freetronics/RelayDriverShield8/RelayDriverShield8-v2_1-schematic.pdf

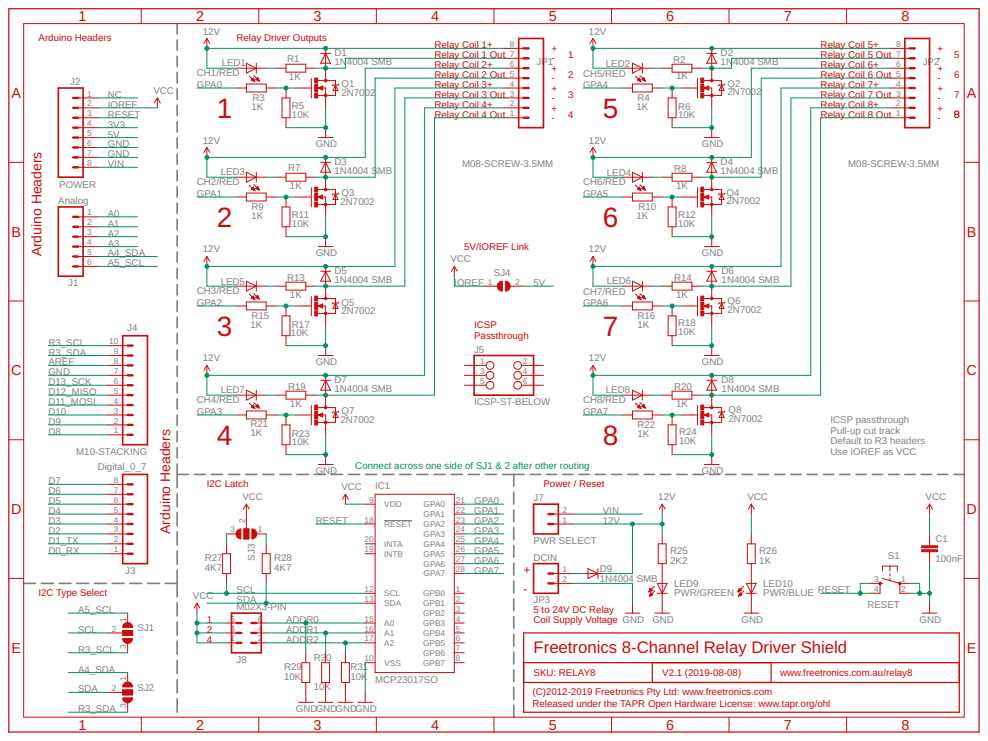
[picture p1: page 1]

Relay Coil 1+ Relay Coil 2+ Relay Coil 3+ Relay Coil 4+ Relay Coil 4 Out
Relay Coil 1 Out
Relay Coil 2 Out
Relay Coil 3 Out

Relay Coil 5+ Relay Coil 5 Out
Relay Coil 6+ Relay Coil 6 Out
Relay Coil 7+ Relay Coil 7 Out
Relay Coil 8+
Relay Coil 8 Out

ICSP passthrough
Pull-up cut track
Default to R3 headers Use IOREF as VCC

5 to 24V DC Relay
Freetronics 8-Channel Relay Driver Shield

Released under the TAPR Open Hardware License: www.tapr.org/ohl www.freetronics.com.au/relay8 SKU: RELAY8 | V2.1 (2019-08-08)

(C)2012-2019 Freetronics Pty Ltd: www.freetronics.com
