freetronics/RelayDriverShield8/RelayDriverShield8.brd

## EAGLE design RelayDriverShield8.brd (2019-08-08)

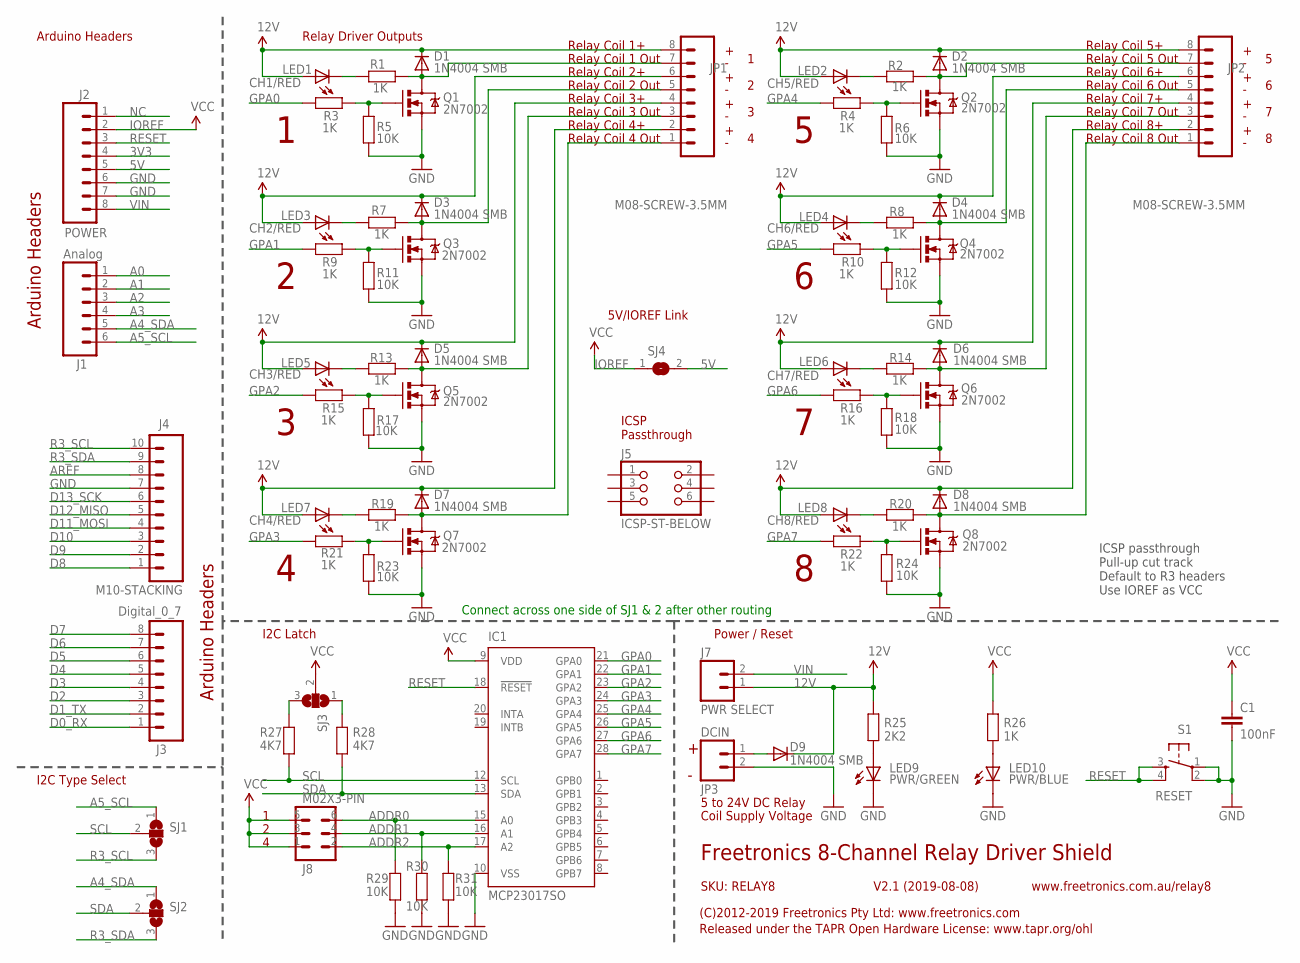
[picture p2: schematic RelayDriverShield8.sch]

Parts:
C1: 100nF; C0603
D1, D2, D3, D4, D5, D6, D7, D8, D9: 1N4004 SMB; SMA-DIODE
IC1: MCP23017SO; SO28W
J1: Analog; 1X06-ST
J2: POWER; 1X08-ST
J3: Digital_0_7; 1X08-ST
J4: M10-STACKING; 1X10-ST
J5: ICSP-ST-BELOW; 2X03-ICSP-ST-BELOW
J7: PWR SELECT; 1X02-P
J8: M02X3-PIN; 2X03-P
JP1, JP2: M08-SCREW-3.5MM; SCREWTERMINAL_3.5MM_8
JP3: DCIN; SCREWTERMINAL-3.5MM-2
LED1: CH1/RED; LED-0603
LED2: CH5/RED; LED-0603
LED3: CH2/RED; LED-0603
LED4: CH6/RED; LED-0603
LED5: CH3/RED; LED-0603
LED6: CH7/RED; LED-0603
LED7: CH4/RED; LED-0603
LED8: CH8/RED; LED-0603
LED9: PWR/GREEN; LED-0603
LED10: PWR/BLUE; LED-0603
Q1, Q2, Q3, Q4, Q5, Q6, Q7, Q8: 2N7002; SOT23-3
R1, R2, R3, R4, R7, R8, R9, R10, R13, R14, R15, R16, R19, R20, R21, R22, R26: 1K; R0603
R5, R6, R11, R12, R17, R18, R23, R24, R29, R30, R31: 10K; R0603
R25: 2K2; R0603
R27, R28: 4K7; R0603
S1: RESET; TACTILE_SMT-6MM
SJ1, SJ2, SJ3: SJ2W; SJ_2
SJ4: SJN; SJ

Connections:
3V3: J2.4
5V: J2.5, SJ4.2
12V: D1.C, D2.C, D3.C, D4.C, D5.C, D6.C, D7.C, D8.C, D9.C, J7.1, JP1.2, JP1.4, JP1.6, JP1.8, JP2.2, JP2.4, JP2.6, JP2.8, LED1.A, LED2.A, LED3.A, LED4.A, LED5.A, LED6.A, LED7.A, LED8.A, R25.2
A0: J1.1
A1: J1.2
A2: J1.3
A3: J1.4
A4_SDA: J1.5, SJ2.1
A5_SCL: J1.6, SJ1.1
ADDR0: IC1.15 (A0), J8.6, R29.2
ADDR1: IC1.16 (A1), J8.4, R30.2
ADDR2: IC1.17 (A2), J8.2, R31.2
AREF: J4.8
D0_RX: J3.1
D1_TX: J3.2
D2: J3.3
D3: J3.4
D4: J3.5
D5: J3.6
D6: J3.7
D7: J3.8
D8: J4.1
D9: J4.2
D10: J4.3
D11_MOSI: J4.4
D12_MISO: J4.5
D13_SCK: J4.6
GND: C1.2, IC1.10 (VSS), J2.6, J2.7, J4.7, JP3.2, LED9.C, LED10.C, Q1.2 (S), Q2.2 (S), Q3.2 (S), Q4.2 (S), Q5.2 (S), Q6.2 (S), Q7.2 (S), Q8.2 (S), R5.1, R6.1, R11.1, R12.1, R17.1, R18.1, R23.1, R24.1, R29.1, R30.1, R31.1, S1.1, S1.2
GPA0: IC1.21 (GPA0), R3.2
GPA1: IC1.22 (GPA1), R9.2
GPA2: IC1.23 (GPA2), R15.2
GPA3: IC1.24 (GPA3), R21.2
GPA4: IC1.25 (GPA4), R4.2
GPA5: IC1.26 (GPA5), R10.2
GPA6: IC1.27 (GPA6), R16.2
GPA7: IC1.28 (GPA7), R22.2
IOREF: C1.1, IC1.9 (VDD), J2.2, J8.1, J8.3, J8.5, R26.2, SJ3.2, SJ4.1
unnamed: Q1.1 (G), R3.1, R5.2
unnamed: D3.A, JP1.5, Q3.3 (D), R7.2
unnamed: LED9.A, R25.1
unnamed: D1.A, JP1.7, Q1.3 (D), R1.2
unnamed: Q3.1 (G), R9.1, R11.2
unnamed: D5.A, JP1.3, Q5.3 (D), R13.2
unnamed: Q5.1 (G), R15.1, R17.2
unnamed: D7.A, JP1.1, Q7.3 (D), R19.2
unnamed: Q7.1 (G), R21.1, R23.2
unnamed: D2.A, JP2.7, Q2.3 (D), R2.2
unnamed: Q2.1 (G), R4.1, R6.2
unnamed: D4.A, JP2.5, Q4.3 (D), R8.2
unnamed: Q4.1 (G), R10.1, R12.2
unnamed: D6.A, JP2.3, Q6.3 (D), R14.2
unnamed: Q6.1 (G), R16.1, R18.2
unnamed: D8.A, JP2.1, Q8.3 (D), R20.2
unnamed: Q8.1 (G), R22.1, R24.2
unnamed: LED3.C, R7.1
unnamed: LED7.C, R19.1
unnamed: LED5.C, R13.1
unnamed: LED1.C, R1.1
unnamed: LED2.C, R2.1
unnamed: LED4.C, R8.1
unnamed: LED6.C, R14.1
unnamed: LED8.C, R20.1
unnamed: D9.A, JP3.1
unnamed: R27.2, SJ3.3
unnamed: R28.2, SJ3.1
unnamed: LED10.A, R26.1
NC: J2.1
R3_SCL: J4.10, SJ1.3
R3_SDA: J4.9, SJ2.3
RESET: IC1.18 (!RESET), J2.3, S1.3, S1.4
SCL: IC1.12 (SCL), R27.1, SJ1.2
SDA: IC1.13 (SDA), R28.1, SJ2.2
VIN: J2.8, J7.2

Notes on the sheet:
Freetronics 8-Channel Relay Driver Shield
V2.1 (2019-08-08)
SKU: RELAY8
Arduino Headers
Power / Reset
I2C Latch
(C)2012-2019 Freetronics Pty Ltd: www.freetronics.com
Released under the TAPR Open Hardware License: www.tapr.org/ohl
www.freetronics.com.au/relay8
I2C Type Select
Relay Coil 1 Out
Relay Coil 1+
Relay Coil 2+
Relay Coil 3+
Relay Coil 4+
Relay Coil 4 Out
Relay Coil 3 Out
Relay Coil 2 Out
Relay Coil 8 Out
Relay Coil 8+
Relay Coil 5+
Relay Coil 5 Out
Relay Coil 6+
Relay Coil 6 Out
Relay Coil 7+
Relay Coil 7 Out
5 to 24V DC Relay
Coil Supply Voltage
Relay Driver Outputs
Connect across one side of SJ1 & 2 after other routing
ICSP passthrough Pull-up cut track Default to R3 headers Use IOREF as VCC
ICSP Passthrough
5V/IOREF Link

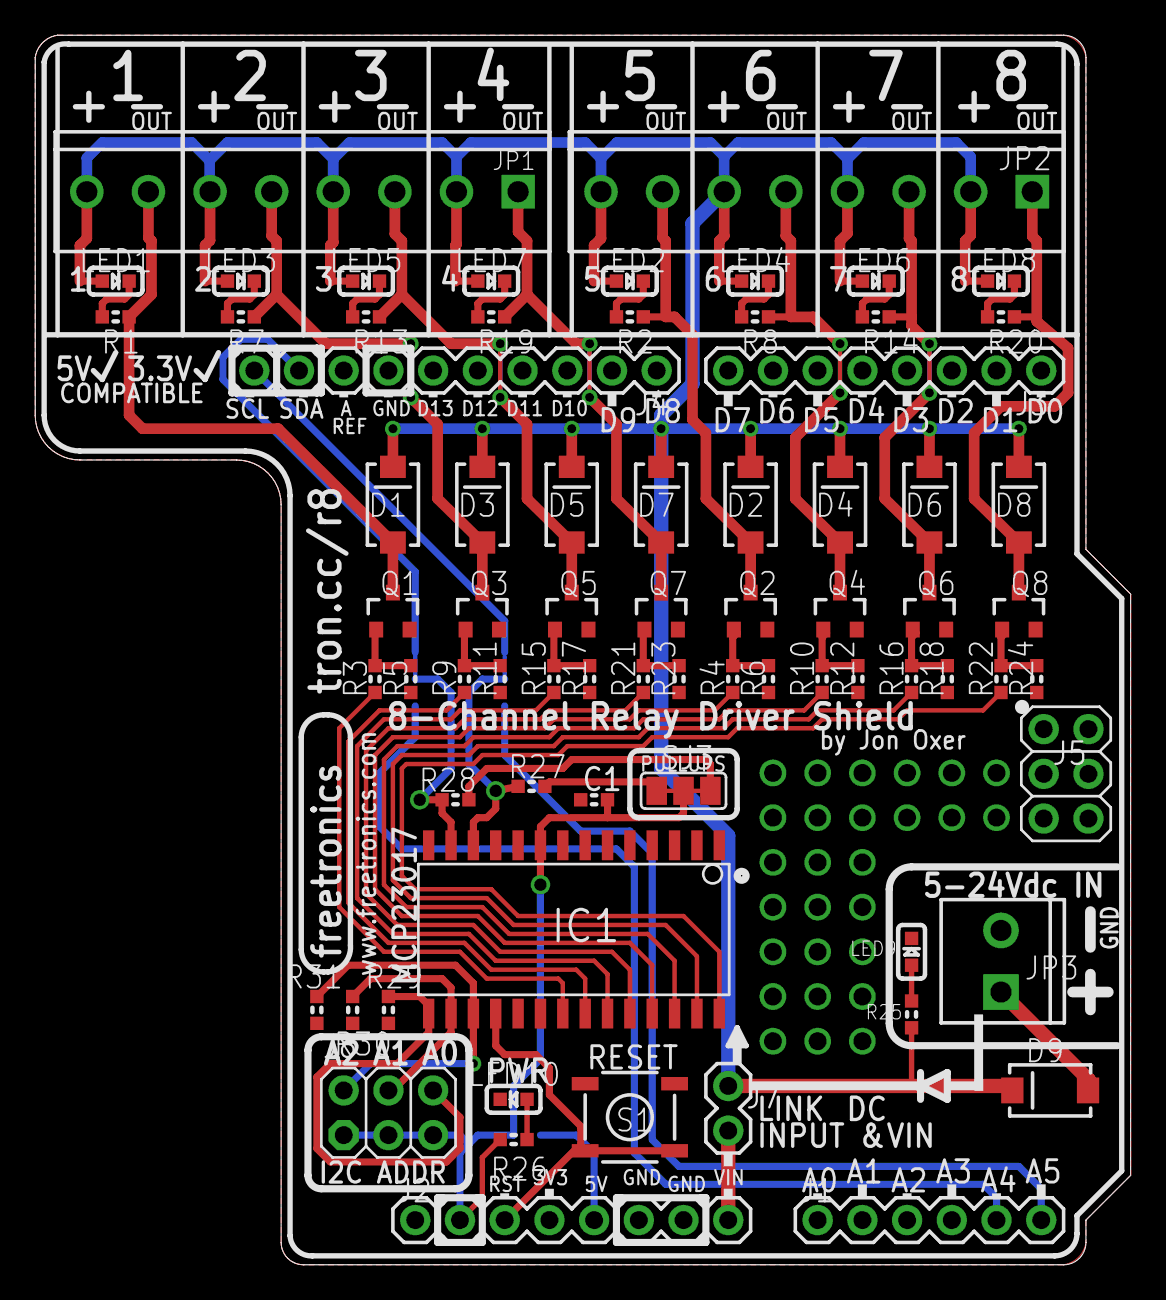
[picture p3: board RelayDriverShield8.brd from above]

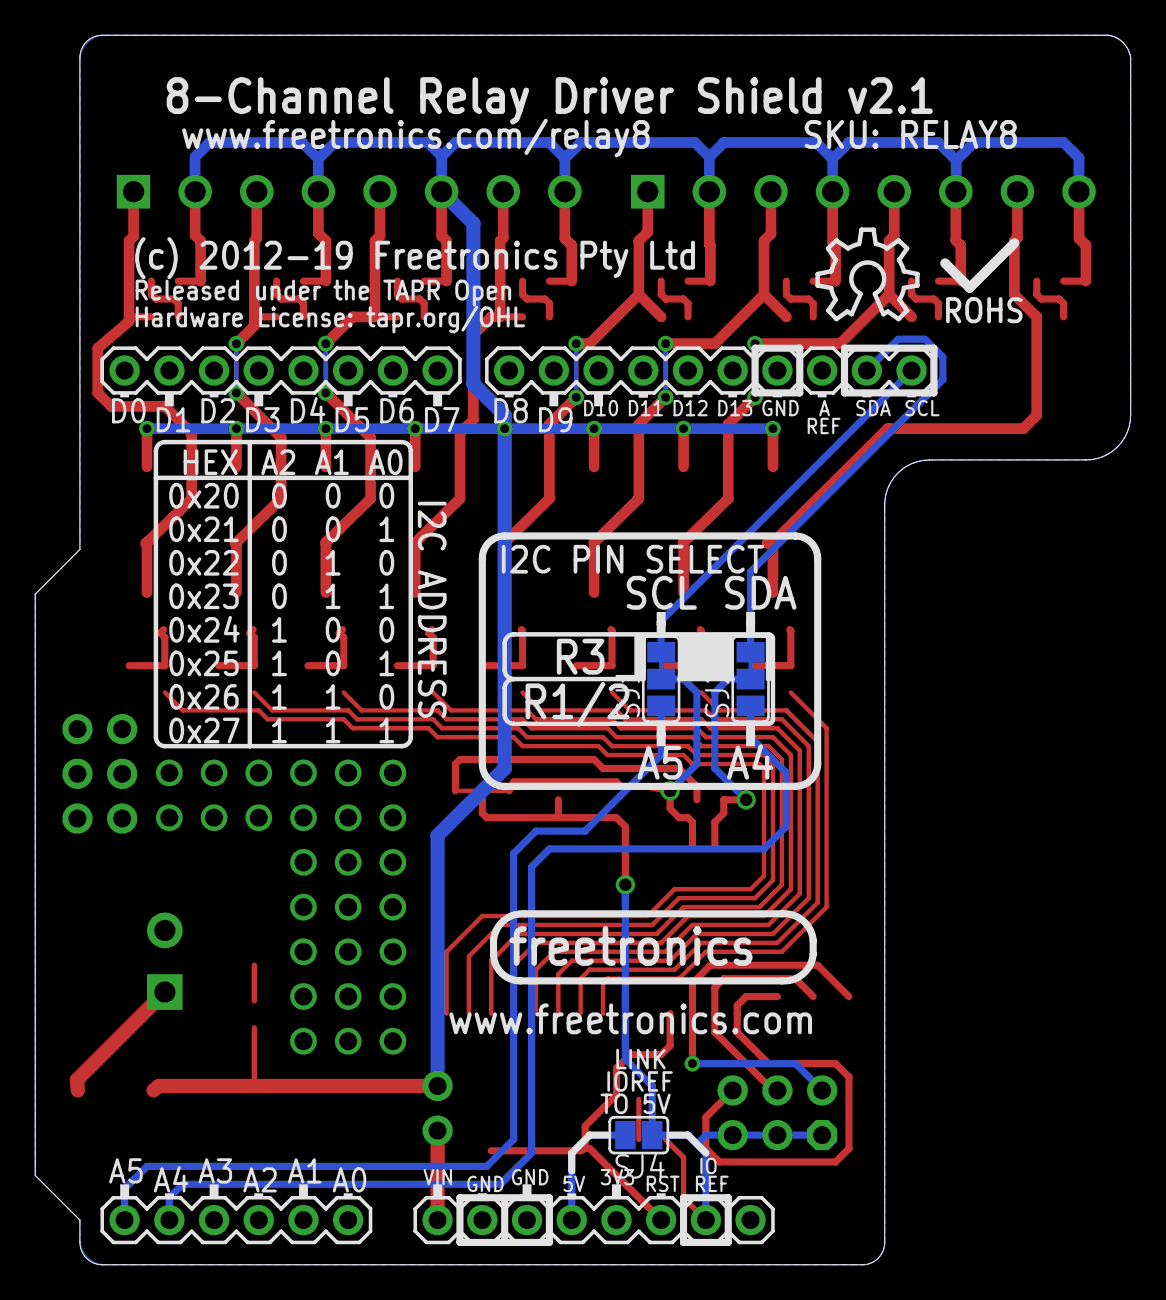
[picture p4: board RelayDriverShield8.brd from below]

Board: 2 copper layers, 62.2 x 69.8 mm, 76 parts (4 on the bottom side), 52 nets.

Other parts of the board:
U$6: OSHW_10X200_NOTEXT
