freetronics/RelayDriverShield8/(commit log)

2012-02-14 Initial project import
    [RelayDriverShield8.brd, RelayDriverShield8.sch]
2012-02-28 Layout and schematic fixes, getting closer to 1.0
    [RelayDriverShield8.brd, RelayDriverShield8.sch]
2012-03-25 Updated overlay, schematic, and license for v1.0 release
    [RelayDriverShield8.brd, RelayDriverShield8.sch]
2012-05-01 Experimenting with reshaping the board for larger screw terminals
    [RelayDriverShield8.brd, RelayDriverShield8.sch]
2012-05-02 Experiment with header version selection jumpers
    [RelayDriverShield8.brd]
2012-05-05 Changed restring, improved clearances and routing, replaced pair of 1x3 headers with 2x3
    [RelayDriverShield8.brd, RelayDriverShield8.sch]
2012-05-07 Start of clarifying schematic; replaced Zeners with 1N4004
    [RelayDriverShield8.brd, RelayDriverShield8.sch]
2012-05-10 Schematic, routing, and overlay improvements
    [RelayDriverShield8.brd, RelayDriverShield8.sch]
2012-05-11 Improvements to overlay and schematic
    [RelayDriverShield8.brd, RelayDriverShield8.sch]
2012-05-11 Minor adjustments for production
    [RelayDriverShield8.brd, RelayDriverShield8.sch]
2012-05-12 PDF schematic done
2014-06-03 Default pin selection to R3 headers instead of A4/A5 ICSP header for pass-through Cut-track jumpers to isolate I2C pullups Use IOREF as VCC for compatibility with both 3.3V and 5V hosts Relocate Pwr 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
    [RelayDriverShield8.brd, RelayDriverShield8.sch]
2014-06-03 Updated SKU and schematic PDF
    [RelayDriverShield8.brd, RelayDriverShield8.sch]
2014-06-30 Added solder jumper to link IOREF and 5V
    [RelayDriverShield8.brd, RelayDriverShield8.sch]
2014-06-30 Improved value label positions
    [RelayDriverShield8.brd]
2019-04-24 Improved designator clarity
    [RelayDriverShield8.brd]
2019-08-08 Replaced parts using SuperHouse library to add 3D models
    [RelayDriverShield8.brd, RelayDriverShield8.sch]
2021-03-11 Added PDF of schematic.
