freetronics/RelayDriverShield8/(notices)

Notices in the files:
RelayDriverShield8.brd:
(c) 2012-19 Freetronics Pty Ltd
Hardware License: tapr.org/OHL
